nebularnoise/PopLab_CNC/embedded_ctrl/embedded_ctrl.kicad_pcb

## KiCad design embedded_ctrl/embedded_ctrl.kicad_pcb (2025-06-30)

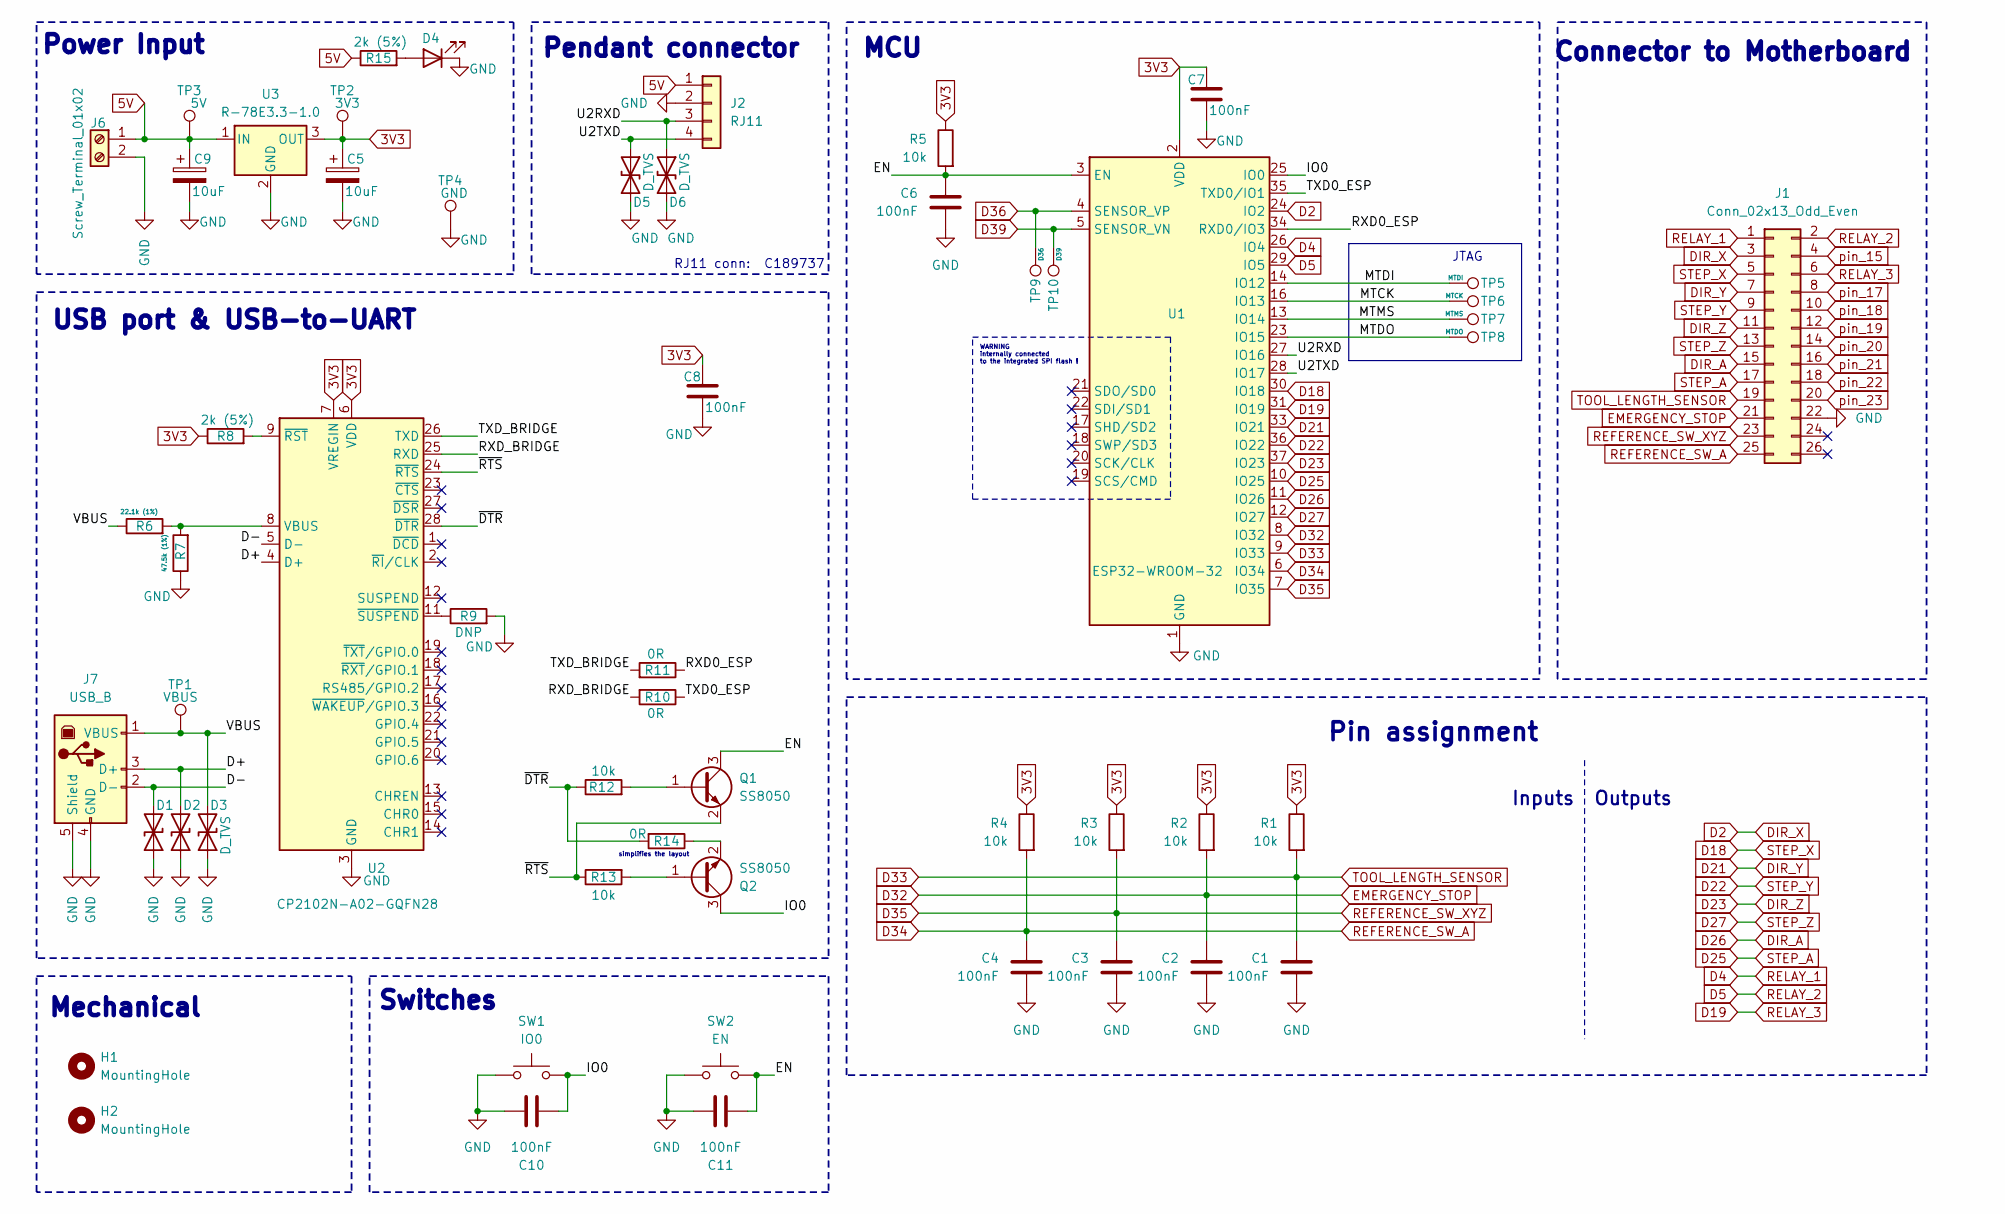
[picture p1: schematic embedded_ctrl.kicad_sch]

Parts:
C1, C2, C3, C4, C6, C7, C8, C10, C11: 100nF; C_0603_1608Metric; JLCPCB Part # C14663
C5, C9: 10uF; CP_Elec_5x5.4; JLCPCB Part # C72487
D1, D2, D3, D5, D6: D_TVS; D_0603_1608Metric; JLCPCB Part # C316054
D4: LED; D_0603_1608Metric; JLCPCB Part # C2286
H1, H2: MountingHole; MountingHole_3.2mm_M3
J1: Conn_02x13_Odd_Even; PinHeader_2x13_P2.54mm_Horizontal; JLCPCB Part # C2894993
J2: RJ11; RJ11_C189737
J6: Screw_Terminal_01x02; TerminalBlock_Phoenix_MKDS-1,5-2_1x02_P5.00mm_Horizontal; JLCPCB Part # C8465
J7: USB_B; USB_B_OST_USB-B1HSxx_Horizontal; JLCPCB Part # C720549
Q1, Q2: SS8050; SOT-23; JLCPCB Part # C2150
R1, R2, R3, R4, R5, R12, R13: 10k; R_0603_1608Metric; JLCPCB Part # C25804
R6: 22.1k (1%); R_0603_1608Metric; JLCPCB Part # C25961
R7: 47.5k (1%); R_0603_1608Metric; JLCPCB Part # C25961
R8, R15: 2k (5%); R_0603_1608Metric; JLCPCB Part # C22975
R9: DNP; R_0603_1608Metric
R10, R11, R14: 0R; R_0603_1608Metric; JLCPCB Part # C21189
SW1: IO0; SW_Push_1P1T_NO_Vertical_Wuerth_434133025816
SW2: EN; SW_Push_1P1T_NO_Vertical_Wuerth_434133025816
TP1: VBUS; TestPoint_THTPad_D1.0mm_Drill0.5mm
TP2: 3V3; TestPoint_THTPad_D1.0mm_Drill0.5mm
TP3: 5V; TestPoint_THTPad_D1.0mm_Drill0.5mm
TP4: GND; TestPoint_THTPad_D1.0mm_Drill0.5mm
TP5: MTDI; TestPoint_Pad_D1.0mm
TP6: MTCK; TestPoint_Pad_D1.0mm
TP7: MTMS; TestPoint_Pad_D1.0mm
TP8: MTDO; TestPoint_Pad_D1.0mm
TP9: D36; TestPoint_Pad_D1.0mm
TP10: D39; TestPoint_Pad_D1.0mm
U1: ESP32-WROOM-32
U2: CP2102N-A02-GQFN28; QFN-28-1EP_5x5mm_P0.5mm_EP3.35x3.35mm; JLCPCB Part # C964632
U3: R-78E3.3-1.0; Converter_DCDC_RECOM_R-78E-0.5_THT; JLCPCB Part # C18212316

Connections:
3V3: C5.1, C7.1, C8.1, R1.1, R2.1, R3.1, R4.1, R5.1, R8.1, TP2.1, U1.2 (VDD), U2.6 (VDD), U2.7 (VREGIN), U3.3 (OUT)
5V: C9.1, J2.1, J6.1, R15.1, TP3.1, U3.1 (IN)
/D+: D2.2 (A2), J7.3 (D+), U2.4 (D+)
/D-: D1.2 (A2), J7.2 (D-), U2.5 (D-)
/EN: C6.1, C11.1, Q1.3 (C), R5.2, SW2.2, U1.3 (EN)
/IO0: C10.1, Q2.3 (C), SW1.2, U1.25 (IO0)
/MTCK: TP6.1, U1.16 (IO13)
/MTDI: TP5.1, U1.14 (IO12)
/MTDO: TP8.1, U1.23 (IO15)
/MTMS: TP7.1, U1.13 (IO14)
/RXD0_ESP: R11.1, U1.34 (RXD0/IO3)
/RXD_BRIDGE: R10.2, U2.25 (RXD)
/TXD0_ESP: R10.1, U1.35 (TXD0/IO1)
/TXD_BRIDGE: R11.2, U2.26 (TXD)
/U2RXD: D6.1 (A1), J2.3, U1.27 (IO16)
/U2TXD: D5.1 (A1), J2.4, U1.28 (IO17)
/VBUS: D3.2 (A2), J7.1 (VBUS), R6.1, TP1.1
/~DTR: R12.1, R14.2, U2.28 (~DTR)
/~RTS: Q1.2 (E), R13.1, U2.24 (~RTS)
D2: J1.3, U1.24 (IO2)
D4: J1.1, U1.26 (IO4)
D5: J1.2, U1.29 (IO5)
D18: J1.5, U1.30 (IO18)
D19: J1.6, U1.31 (IO19)
D21: J1.7, U1.33 (IO21)
D22: J1.9, U1.36 (IO22)
D23: J1.11, U1.37 (IO23)
D25: J1.17, U1.10 (IO25)
D26: J1.15, U1.11 (IO26)
D27: J1.13, U1.12 (IO27)
D32: C2.1, J1.21, R2.2, U1.8 (IO32)
D33: C1.1, J1.19, R1.2, U1.9 (IO33)
D34: C4.1, J1.25, R4.2, U1.6 (IO34)
D35: C3.1, J1.23, R3.2, U1.7 (IO35)
D36: TP9.1, U1.4 (SENSOR_VP)
D39: TP10.1, U1.5 (SENSOR_VN)
GND: C1.2, C2.2, C3.2, C4.2, C5.2, C6.2, C7.2, C8.2, C9.2, C10.2, C11.2, D1.1 (A1), D2.1 (A1), D3.1 (A1), D4.1 (K), D5.2 (A2), D6.2 (A2), J1.22, J2.2, J6.2, J7.4 (GND), J7.5 (Shield), R7.1, R9.2, SW1.1, SW2.1, TP4.1, U1.1 (GND), U1.15 (GND), U1.38 (GND), U1.39 (GND), U2.3 (GND), U2.29 (GND), U3.2 (GND)
unnamed: D4.2 (A), R15.2
unnamed: Q1.1 (B), R12.2
unnamed: Q2.1 (B), R13.2
unnamed: Q2.2 (E), R14.1
unnamed: R6.2, R7.2, U2.8 (VBUS)
unnamed: R8.2, U2.9 (~RST)
unnamed: R9.1, U2.11 (~SUSPEND)
pin_15: J1.4
pin_17: J1.8
pin_18: J1.10
pin_19: J1.12
pin_20: J1.14
pin_21: J1.16
pin_22: J1.18
pin_23: J1.20

Notes on the sheet:
Outputs
JTAG
RJ11 conn: C189737
Power Input
Inputs
simplifies the layout
Mechanical
Connector to Motherboard
Switches
Pendant connector
Pin assignment
USB port & USB-to-UART
MCU
WARNING internally connected to the integrated SPI flash !

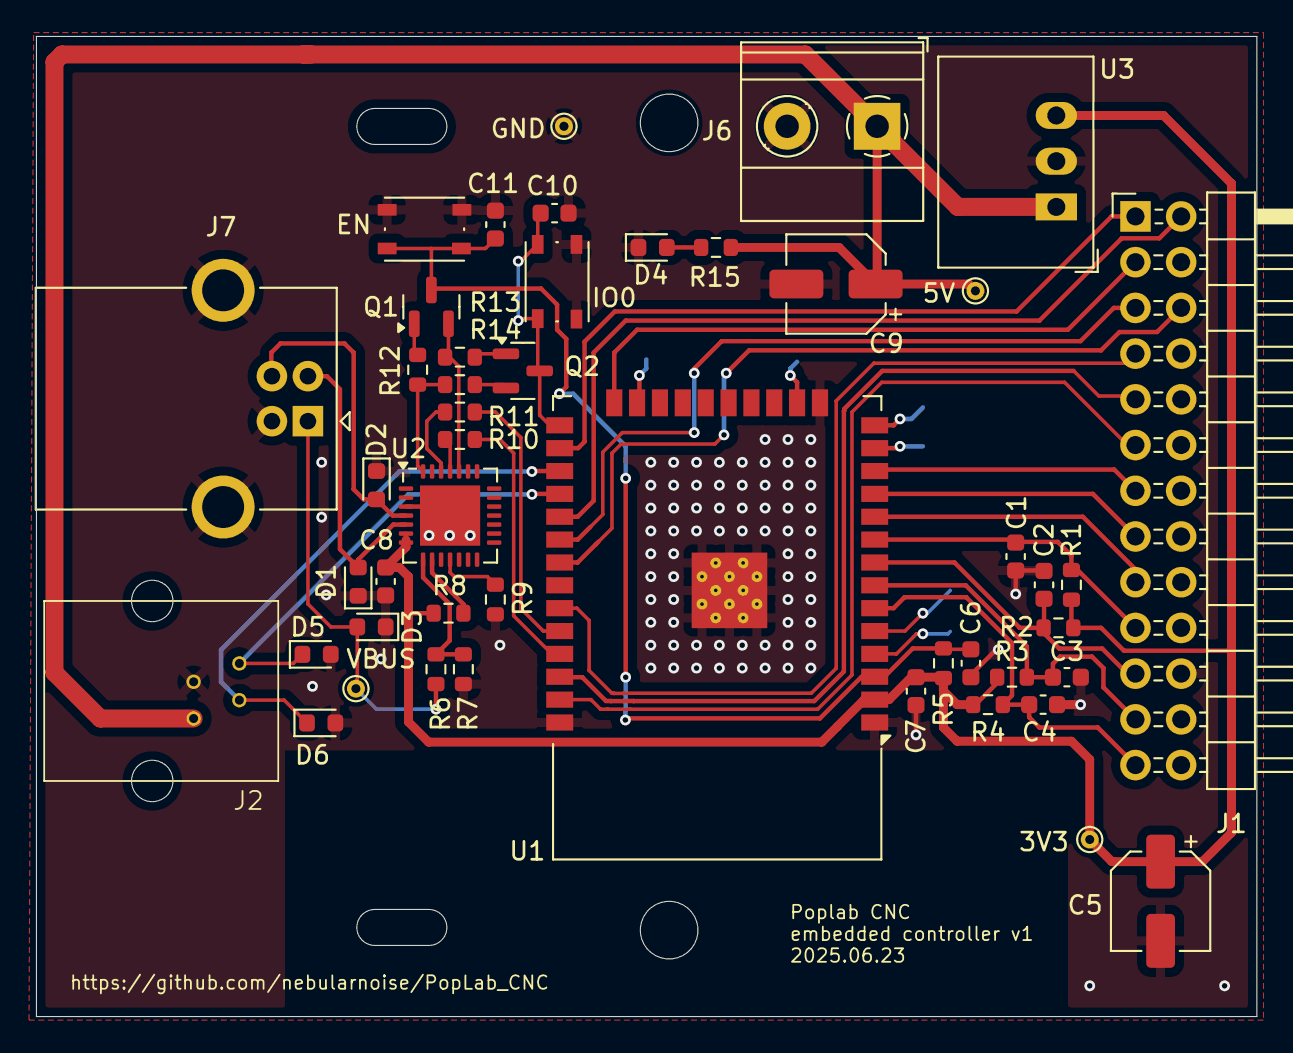
[picture p2: board embedded_ctrl.kicad_pcb from above]

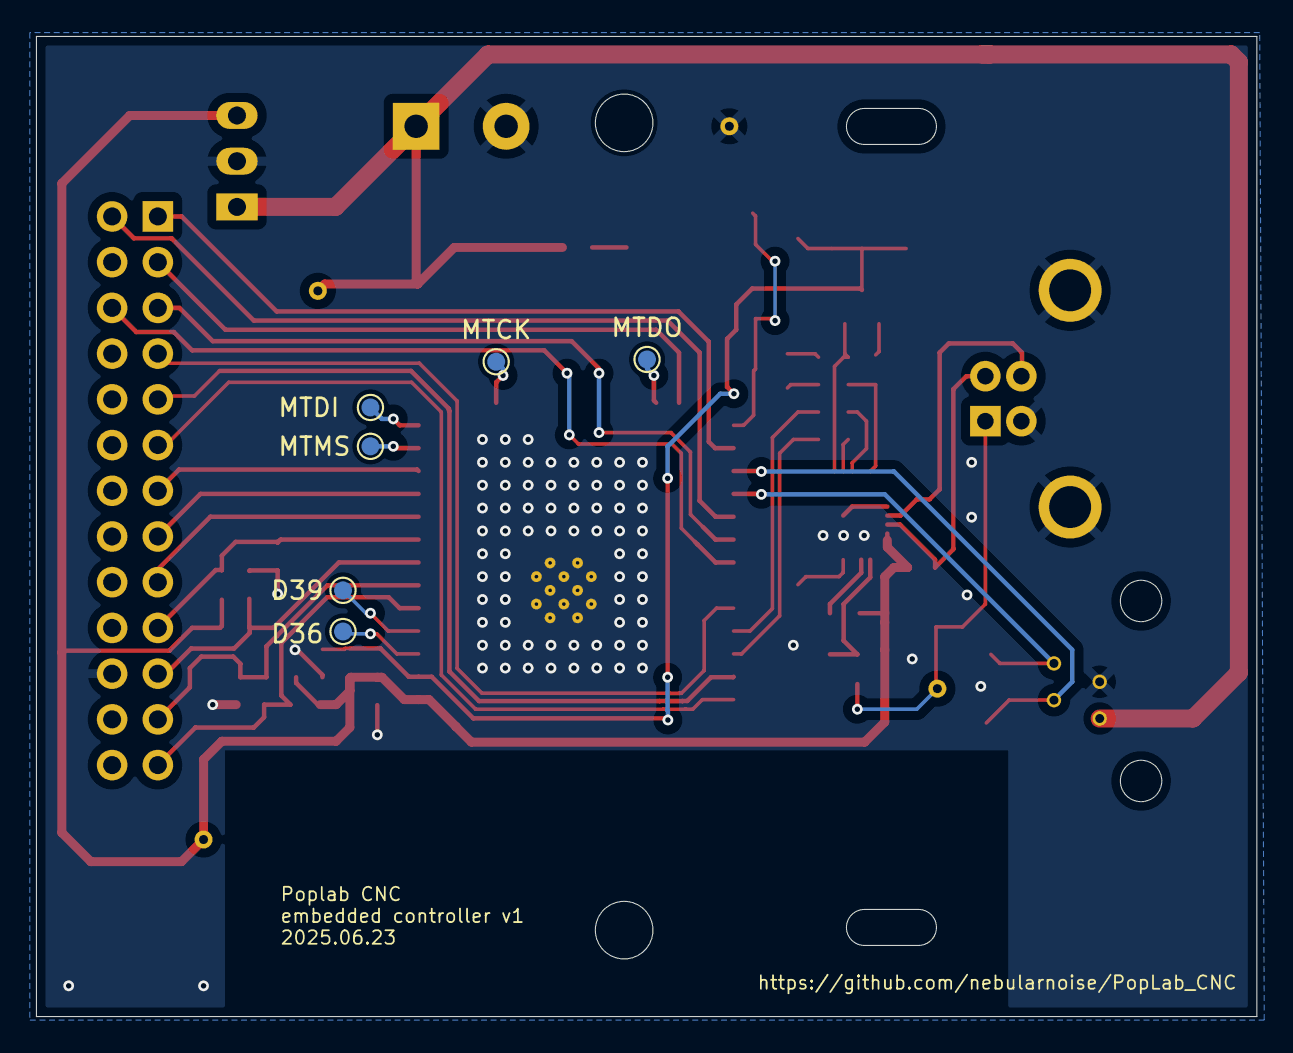
[picture p3: board embedded_ctrl.kicad_pcb from below]

Board: 2 copper layers, 67.8 x 54.5 mm, 55 parts (6 on the bottom side), 44 nets.
