nebularnoise/PopLab_CNC/sc100_ff/sc100_ff.kicad_pcb

## KiCad design sc100_ff/sc100_ff.kicad_pcb (2025-06-20)

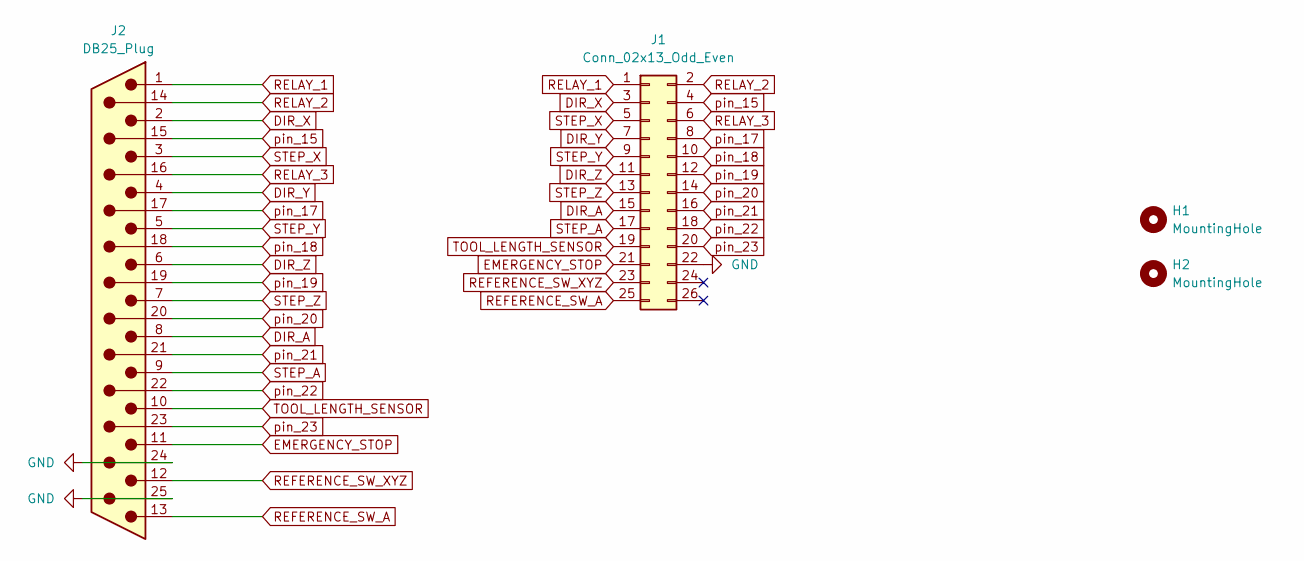
[picture p4: schematic sc100_ff.kicad_sch]

Parts:
H1, H2: MountingHole; MountingHole_3.2mm_M3
J1: Conn_02x13_Odd_Even; PinHeader_2x13_P2.54mm_Horizontal
J2: DB25_Plug; DSUB-25_Male_Horizontal_P2.77x2.54mm_EdgePinOffset9.40mm

Connections:
DIR_A: J1.15, J2.8
DIR_X: J1.3, J2.2
DIR_Y: J1.7, J2.4
DIR_Z: J1.11, J2.6
EMERGENCY_STOP: J1.21, J2.11
GND: J1.22, J2.24, J2.25
REFERENCE_SW_A: J1.25, J2.13
REFERENCE_SW_XYZ: J1.23, J2.12
RELAY_1: J1.1, J2.1
RELAY_2: J1.2, J2.14
RELAY_3: J1.6, J2.16
STEP_A: J1.17, J2.9
STEP_X: J1.5, J2.3
STEP_Y: J1.9, J2.5
STEP_Z: J1.13, J2.7
TOOL_LENGTH_SENSOR: J1.19, J2.10
pin_15: J1.4, J2.15
pin_17: J1.8, J2.17
pin_18: J1.10, J2.18
pin_19: J1.12, J2.19
pin_20: J1.14, J2.20
pin_21: J1.16, J2.21
pin_22: J1.18, J2.22
pin_23: J1.20, J2.23

Board: 2 copper layers, 4 parts (0 on the bottom side), 24 nets, no tracks yet.
