nebularnoise/PopLab_CNC/cnc_adapter/cnc_adapter.kicad_pcb

## KiCad design cnc_adapter/cnc_adapter.kicad_pcb (2025-06-04)

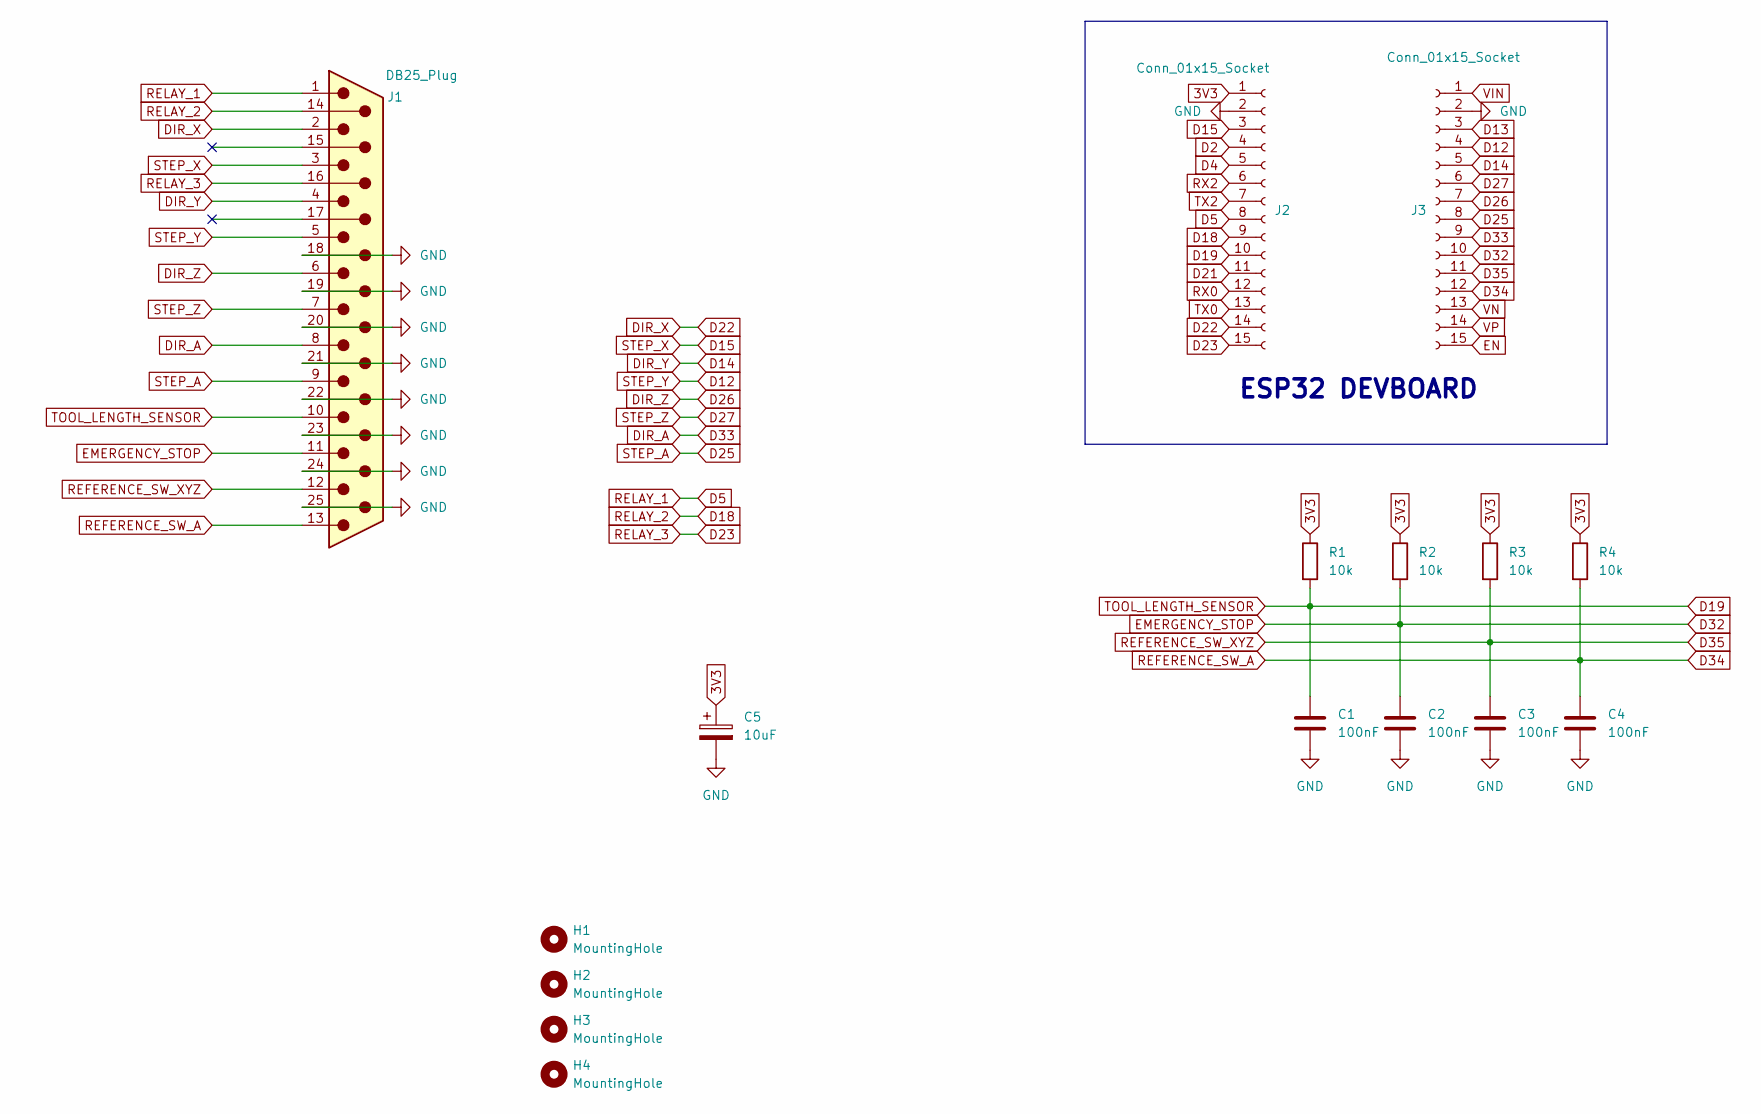
[picture p5: schematic cnc_adapter.kicad_sch]

Parts:
C1, C2, C3, C4: 100nF; C_0603_1608Metric
C5: 10uF; CP_Elec_5x5.8
H1, H2, H3, H4: MountingHole; MountingHole_2.7mm_M2.5
J1: DB25_Plug; DSUB-25_Female_EdgeMount_P2.77mm
J2, J3: Conn_01x15_Socket; PinSocket_1x15_P2.54mm_Vertical
R1, R2, R3, R4: 10k; R_0603_1608Metric

Connections:
3V3: C5.1, J2.1, R1.1, R2.1, R3.1, R4.1
D2: J2.4
D4: J2.5
D5: J1.1, J2.8
D12: J1.5, J3.4
D13: J3.3
D14: J1.4, J3.5
D15: J1.3, J2.3
D18: J1.14, J2.9
D19: C1.1, J1.10, J2.10, R1.2
D21: J2.11
D22: J1.2, J2.14
D23: J1.16, J2.15
D25: J1.9, J3.8
D26: J1.6, J3.7
D27: J1.7, J3.6
D32: C2.1, J1.11, J3.10, R2.2
D33: J1.8, J3.9
D34: C4.1, J1.13, J3.12, R4.2
D35: C3.1, J1.12, J3.11, R3.2
EN: J3.15
GND: C1.2, C2.2, C3.2, C4.2, C5.2, J1.18, J1.19, J1.20, J1.21, J1.22, J1.23, J1.24, J1.25, J2.2, J3.2
RX0: J2.12
RX2: J2.6
TX0: J2.13
TX2: J2.7
VIN: J3.1
VN: J3.13
VP: J3.14

Notes on the sheet:
ESP32 DEVBOARD

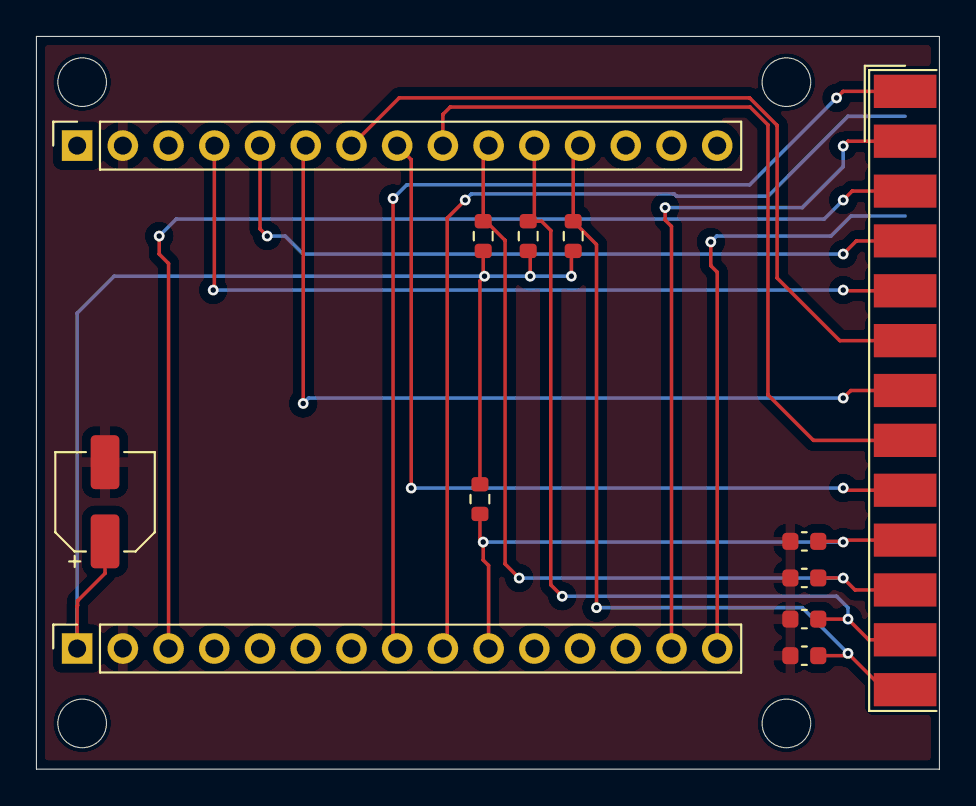
[picture p6: board cnc_adapter.kicad_pcb from above]

Board: 2 copper layers, 50.2 x 40.7 mm, 16 parts (0 on the bottom side), 17 nets.
