nebularnoise/PopLab_CNC/(threads)

Thread 1 (2024-06-01):

Câblage 220V pour bouton d'arrêt d'urgence

nebularnoise, 2024-06-01:
Les moteurs d'axes et le moteur de défonçeuse sont indépendants.

Un bouton d'arrêt d'urgence doit **nécéssairement** couper l'alimentation des deux

====

Le plus simple a imaginer, c'est ce genre de choses:

```mermaid
graph TD;
     prise[Prise électrique];
    BAU[Bouton d'arrêt d'urgence];
    M(Multiprise);
    CNC[Stepcraft 420];
    S[Spindle];

    prise === BAU;
    BAU === M;

    M === CNC;

    M === S;

     linkStyle 0,1,2,3 stroke:red,stroke-width:4px;

```

```mermaid
graph TD;
     prise[Prise électrique];
    BAU[Bouton d'arrêt d'urgence];
    M(Multiprise);
    CNC[Stepcraft 420];
    Relai;
    S((Spindle));

    prise === BAU;
    BAU === M;

    M ==== CNC;

    M === Relai;
    Relai === S;

     linkStyle 0,1,2,3,4 stroke:red,stroke-width:4px;

    F[FluidCNC];
    OVR(Manual override);

    F  ---o Relai;
    OVR ---o Relai;

    CNC o-.- F;

```

On pourrait aussi ajouter une sécurité pour éteindre la fraiseuse lorsqu'un "job" est terminé. Pour ça, on pourrait utiliser un relai pour fournir ou non du courant au moteur spindle. Il faudrait alors configurer le GCode en conséquence, pour que la spindle démarre lorsque c'est opportun.

nebularnoise, 2024-06-01:
@Simon-L

Thread 2 (2024-06-01):

Controleur FluidCNC - Design Hardware

nebularnoise, 2024-06-01:
FluidCNC a l'air très prometteur.

# Flasher FluidCNC sur une devboard ESP32-WROOM
J'ai flashé FluidCNC sur un ESP32, en utilisant le "Web Installer", qui utilise le protocole WebSerial.
A noter que j'ai dû:
- utiliser Chromium, car WebSerial n'est pas implémenté par Firefox
- M'ajouter au groupe "uucp" ("dialout" dans les Debian-like) pour avoir les droits sur ttyUSB0

# Référence hardware
https://hackaday.io/project/194302-convert-a-mach3-cnc-controller-to-grbl-or-fluidnc/details

# I/O
Un argument pour faire une board custom, c'est de pouvoir prévoir d'éventuels _"pendants"_, comme par exemple un jogwheel manuel ou un écran de status.
Du coup, le contrôleur aurait non seulement un USB femelle (type B full-size de préférence), mais aussi des ports "pendants". Je serais assez chaud pour utiliser des prises RJ11.

# Power
Le truc à trancher aussi, c'est la source d'alimentation du contrôleur.
La référence ci-dessus alimente l'ESP32 via l'USB. Pour un cas d'usage simple, pourquoi pas, mais si on envisage un jogwheel manuel par la suite, ça tombe vite à l'eau. Du coup, peut etre prévoir une alim dédiée pour cette board. Si on prends ensuite un bête transfo à découpage pour avoir du DC basse tension, il suffirait de brancher ce transfo sur la multiprise en aval du bouton d'arret d'urgence.

nebularnoise, 2025-06-18:
La devboard en question est la suivante: `ESP32-DevKitC V4`

Doc:
https://docs.espressif.com/projects/esp-dev-kits/en/latest/esp32/esp32-devkitc/user_guide.html

Schematic:
https://dl.espressif.com/dl/schematics/esp32_devkitc_v4_sch.pdf

La datasheet du module `esp32-wroom-32`:
https://www.espressif.com/sites/default/files/documentation/esp32-wroom-32_datasheet_en.pdf

Thread 3 (2024-06-01):

GCode sender - hardware & software

nebularnoise, 2024-06-01:
Quid de ce qu'il y a en amont de FluidCNC ?

Faut il un PC dédié, ou est-ce plutot une approche "Bring Your Own Workstation" ?
L'approche "ordi dédié" peut être pas mal pour s'assurer d'un setup bien carré. Par contre, ça peut causer un certain encombrement.

En terme de software CAM, que choisir ? Universal Gcode Sender est utilisé dans l'article cité dans un autre ticket, mais pleins d'options sont dispo, cf. http://wiki.fluidnc.com/en/support/gcode_senders

Thread 4 (2024-11-20):

Boitier

nebularnoise, 2024-11-20:
Référence assez cool:
https://www.youtube.com/watch?v=kyhl2da42aw

Les différents composants sont pour la pluparts montés sur un rail DIN, c'est vraiment pas une mauvaise idée de réfléchir à ce genre de montage pourle bopitier de controle, ce serait sûrement moins "bricolé" que des relais de récup, etc.

Thread 5 (2025-01-22):

Parallel port LPT adapter (X1) - Reverse engineer

nebularnoise, 2025-01-22:
# Images

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

# Dimensions du PCB, position des trous

???

# BOM
| Ref | Desc |Part id |
|--------|--------|--------|
| X1 | Port parallele CONNFLY ?? | ??|
| SV3 | 13x2 pitch 2.54 en angle |  ??|

# X1 pinout
| Pin | Signal |
|--------|--------|
| 1 | Cell |
| 2 | Cell |
| 3 | Cell |
| 4 | Cell |

nebularnoise, 2025-01-22:
SC100 adapter
67.80mm
54.45mm

trou, offset depuis header 32.65mm, 4,80 du bord
trou diam 3mm, + 1.5mm keepout

header, 10mm du bord gauche (càd droit bottom), flush avec le bord

Thread 6 (2025-06-25):

Infos Stepcraft 420

nebularnoise, 2025-06-25:
Machine table:

L500mm
W324mm
T8mm

Admissible work piece:

- Clamping length: 500mm
- Clamping width: 312mm

Overall size LWH:
552x440x510mm

Travel distance
420x300x140*
("for constructional reasons, the travel distance of the w axis is getting reduced at the end positions of the x axis by 10mm")

Drive of the machine
Bipolar stepper motors, 1,8 degrees per full step

round threaded spindles TR10x3 with a feed/rotation of 3mm
