nebularnoise/PopLab_CNC/(commit log)

2025-01-15 :construction: first draft passive adapter esp32 <-> parallel port
    [cnc_adapter.kicad_pcb, cnc_adapter.kicad_sch]
2025-06-04 Finish draft
    [cnc_adapter.kicad_pcb, cnc_adapter.kicad_sch]
2025-06-04 Add version silkscreen
    [cnc_adapter.kicad_pcb]
2025-06-20 :construction: first draft sc100ff clone
    [sc100_ff.kicad_pcb, sc100_ff.kicad_sch]
2025-06-20 :construction: first draft embedded controller
    wip
    [embedded_ctrl.kicad_pcb, embedded_ctrl.kicad_sch]
2025-06-21 more work on embedded ctrlr
    same-o
    [embedded_ctrl.kicad_pcb, embedded_ctrl.kicad_sch]
2025-06-21 add rj11 connectors for pendants
    [embedded_ctrl.kicad_pcb, embedded_ctrl.kicad_sch]
2025-06-21 improve pcb layout
    [embedded_ctrl.kicad_pcb]
2025-06-22 Reassign pins to free up JTAG pins, just in case
    [embedded_ctrl.kicad_pcb, embedded_ctrl.kicad_sch]
2025-06-22 Don't use UART1 - its pins are already in use for the SPI flash
    [embedded_ctrl.kicad_pcb, embedded_ctrl.kicad_sch]
2025-06-23 Expose D36 and D39. Add buttons for EN and IO0,bodge wire passthrus, and version text
    [embedded_ctrl.kicad_pcb, embedded_ctrl.kicad_sch]
2025-06-30 add tvs diodes to uart connector
    [embedded_ctrl.kicad_pcb, embedded_ctrl.kicad_sch]
2025-06-30 trace and ignore gerbers
